TalosThoren/MM-control-2.0/rev.03/MM-control.sch

## KiCad design rev.03/MM-control.sch (2020-08-01)

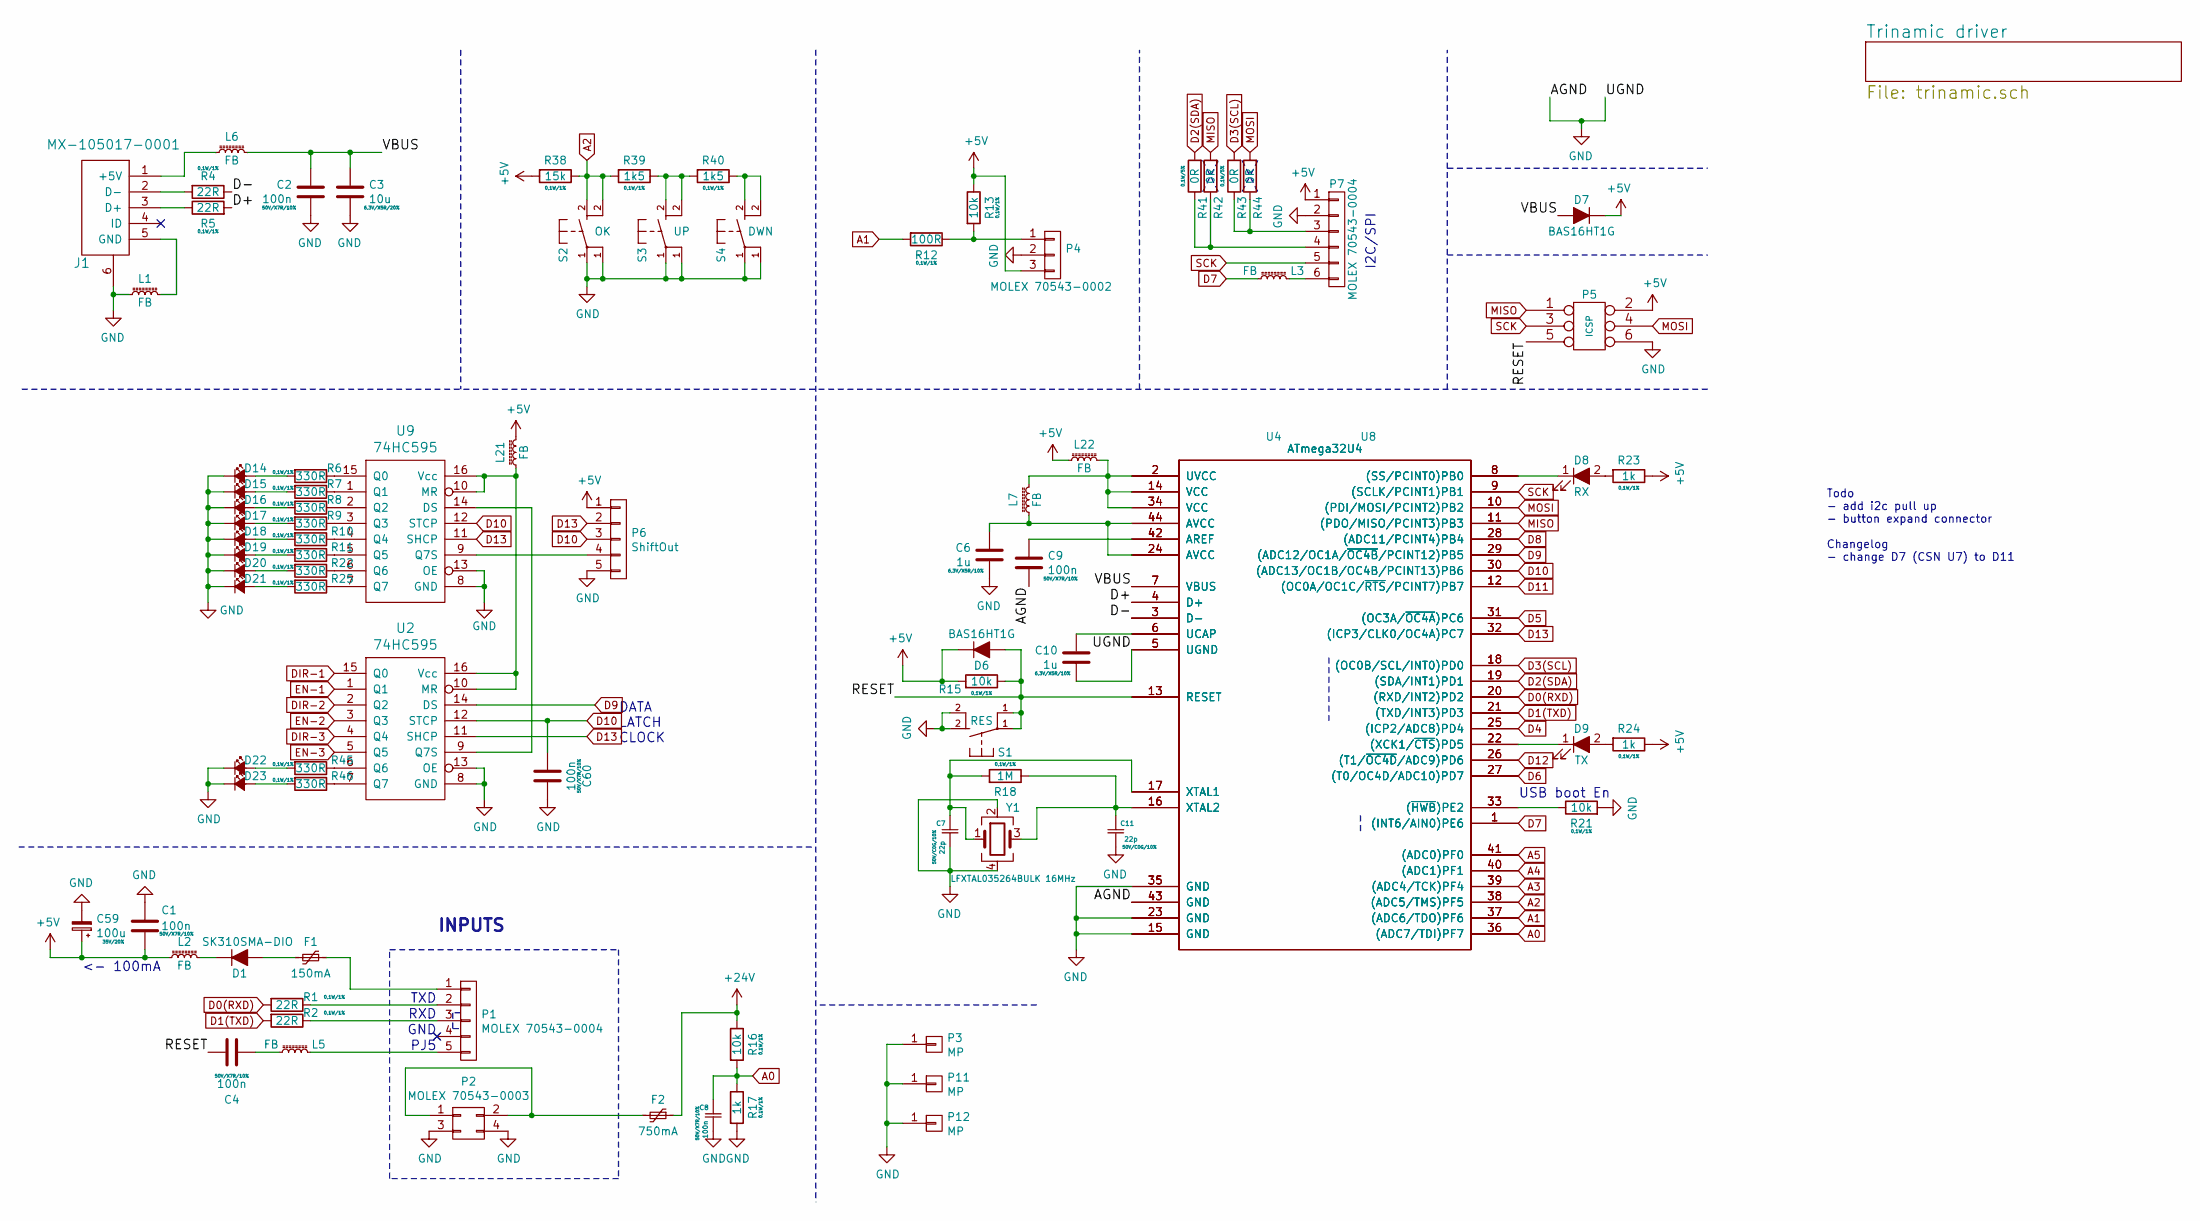
[picture p1: schematic MM-control.sch]

Parts:
C1, C2, C4, C8, C9, C60: 100n; C_0603
C3: 10u; C_0603
C6, C10: 1u; C_0603
C7, C11: 22p; C_0603
C59: 100u; c_elec_6.3x7.7
D1: SK310SMA-DIO; SMA_Standard
D6, D7: BAS16HT1G; SOD-323
D8: RX; LED_0805
D9: TX; LED_0805
D14, D16, D18, D20, D22: KPA-3010MGC; LED-1104
D15, D17, D19, D21, D23: KPA-3010SECK; LED-1104
F1: 150mA; R_1812
F2: 750mA; R_1812
J1: MX-105017-0001; USB-micro
L1, L2, L3, L5, L6, L7, L21, L22: FB; R_0603
P1: MOLEX 70543-0004; Pin_1x05-XL
P2: MOLEX 70543-0003; Pin_1x04-XL
P3, P11, P12: MP; MountingHole_3.2mm_M3_ISO14580_Pad
P4: MOLEX 70543-0002; Pin_1x03-XL
P5: ICSP; Pin_Header_Straight_2x03
P6: ShiftOut; Pin_1x05-XL
P7: MOLEX 70543-0004; Pin_1x06-XL
R1, R2, R4, R5: 22R; R_0603
R6, R7, R8, R9, R10, R11, R22, R25, R45, R46: 330R; R_0603
R12: 100R; R_0603
R13, R15, R16, R21: 10k; R_0603
R17, R23, R24: 1k; R_0603
R18: 1M; R_0603
R38: 15k; R_0603
R39, R40: 1k5; R_0603
R41, R42, R43, R44: 0R; R_0603
S1: RES; TACT-90
S2: OK; TACT-90
S3: UP; TACT-90
S4: DWN; TACT-90
U2, U9: 74HC595; SOIC-16_3.9x9.9mm_Pitch1.27mm
U4: ATmega32U4; TQFP-44_10x10mm_Pitch0.8mm
U8: ATmega32U4; QFN-44-1EP_7x7mm_Pitch0.5mm
Y1: LFXTAL035264BULK 16MHz; Crystal-3.2x2.5mm

Connections:
+5V: C1.1, C59.1, D6.1 (K), D7.1 (K), L2.1, L21.2, L22.1, P4.3, P5.2, P6.1, P7.1, R13.1, R15.2, R23.1, R24.1, R38.2
+24V: F2.1, R16.1
A0: C8.1, R16.2, R17.1, U4.36 ((ADC7/TDI)PF7), U8.36 ((ADC7/TDI)PF7)
A1: R12.2, U4.37 ((ADC6/TDO)PF6), U8.37 ((ADC6/TDO)PF6)
A2: R38.1, R39.2, S2.2, U4.38 ((ADC5/TMS)PF5), U8.38 ((ADC5/TMS)PF5)
A3: U4.39 ((ADC4/TCK)PF4), U8.39 ((ADC4/TCK)PF4)
A4: U4.40 ((ADC1)PF1), U8.40 ((ADC1)PF1)
A5: U4.41 ((ADC0)PF0), U8.41 ((ADC0)PF0)
D0(RXD): R1.2, U4.20 ((RXD/INT2)PD2), U8.20 ((RXD/INT2)PD2)
D1(TXD): R2.2, U4.21 ((TXD/INT3)PD3), U8.21 ((TXD/INT3)PD3)
D2(SDA): R41.2, U4.19 ((SDA/INT1)PD1), U8.19 ((SDA/INT1)PD1)
D3(SCL): R43.2, U4.18 ((OC0B/SCL/INT0)PD0), U8.18 ((OC0B/SCL/INT0)PD0)
D4: U4.25 ((ICP2/ADC8)PD4), U8.25 ((ICP2/ADC8)PD4)
D5: U4.31 ((OC3A/~OC4A~)PC6), U8.31 ((OC3A/~OC4A~)PC6)
D6: U4.27 ((T0/OC4D/ADC10)PD7), U8.27 ((T0/OC4D/ADC10)PD7)
D7: L3.1, U4.1 ((INT6/AIN0)PE6), U8.1 ((INT6/AIN0)PE6)
D8: U4.28 ((ADC11/PCINT4)PB4), U8.28 ((ADC11/PCINT4)PB4)
D9: U2.14 (DS), U4.29 ((ADC12/OC1A/~OC4B~/PCINT12)PB5), U8.29 ((ADC12/OC1A/~OC4B~/PCINT12)PB5)
D10: C60.2, P6.3, U2.12 (STCP), U4.30 ((ADC13/OC1B/OC4B/PCINT13)PB6), U8.30 ((ADC13/OC1B/OC4B/PCINT13)PB6), U9.12 (STCP)
D11: U4.12 ((OC0A/OC1C/~RTS~/PCINT7)PB7), U8.12 ((OC0A/OC1C/~RTS~/PCINT7)PB7)
D12: U4.26 ((T1/~OC4D~/ADC9)PD6), U8.26 ((T1/~OC4D~/ADC9)PD6)
D13: P6.2, U2.11 (SHCP), U4.32 ((ICP3/CLK0/OC4A)PC7), U8.32 ((ICP3/CLK0/OC4A)PC7), U9.11 (SHCP)
D+: R5.2, U4.4 (D+), U8.4 (D+)
D-: R4.1, U4.3 (D-), U8.3 (D-)
DIR-1: U2.15 (Q0)
DIR-2: U2.2 (Q2)
DIR-3: U2.4 (Q4)
EN-1: U2.1 (Q1)
EN-2: U2.3 (Q3)
EN-3: U2.5 (Q5)
GND: C1.2, C2.1, C3.1, C6.1, C7.2, C8.2, C9.1, C10.1, C11.2, C59.2, C60.1, D14.1 (K), D15.1 (K), D16.1 (K), D17.1 (K), D18.1 (K), D19.1 (K), D20.1 (K), D21.1 (K), D22.1 (K), D23.1 (K), J1.6, L1.1, P2.3, P2.4, P3.1, P4.2, P5.6, P6.5, P7.2, P11.1, P12.1, R17.2, R21.2, S1.2, S2.1, S3.1, S4.1, U2.8 (GND), U2.13 (OE), U4.5 (UGND), U4.15 (GND), U4.23 (GND), U4.35 (GND), U4.43 (GND), U8.5 (UGND), U8.15 (GND), U8.23 (GND), U8.35 (GND), U8.43 (GND), U9.8 (GND), U9.13 (OE), Y1.2, Y1.4
MISO: P5.1, R42.2, U4.11 ((PDO/MISO/PCINT3)PB3), U8.11 ((PDO/MISO/PCINT3)PB3)
MOSI: P5.4, R44.2, U4.10 ((PDI/MOSI/PCINT2)PB2), U8.10 ((PDI/MOSI/PCINT2)PB2)
unnamed: C4.1, L5.1
unnamed: C6.2, L7.1, U4.24 (AVCC), U4.44 (AVCC), U8.24 (AVCC), U8.44 (AVCC)
unnamed: C7.1, R18.2, U4.17 (XTAL1), U8.17 (XTAL1), Y1.1
unnamed: C9.2, U4.42 (AREF), U8.42 (AREF)
unnamed: C10.2, U4.6 (UCAP), U8.6 (UCAP)
unnamed: C11.1, R18.1, U4.16 (XTAL2), U8.16 (XTAL2), Y1.3
unnamed: D1.1 (K), L2.2
unnamed: D1.2 (A), F1.2
unnamed: D8.1 (K), U4.8 ((SS/PCINT0)PB0), U8.8 ((SS/PCINT0)PB0)
unnamed: D8.2 (A), R23.2
unnamed: D9.1 (K), U4.22 ((XCK1/~CTS~)PD5), U8.22 ((XCK1/~CTS~)PD5)
unnamed: D9.2 (A), R24.2
unnamed: D14.2 (A), R6.2
unnamed: D15.2 (A), R7.2
unnamed: D16.2 (A), R8.2
unnamed: D17.2 (A), R9.2
unnamed: D18.2 (A), R10.2
unnamed: D19.2 (A), R11.2
unnamed: D20.2 (A), R22.2
unnamed: D21.2 (A), R25.2
unnamed: D22.2 (A), R45.2
unnamed: D23.2 (A), R46.2
unnamed: F1.1, P1.1
unnamed: F2.2, P2.1, P2.2
unnamed: J1.1 (+5V), L6.1
unnamed: J1.2 (D-), R4.2
unnamed: J1.3 (D+), R5.1
unnamed: J1.5 (GND), L1.2
unnamed: L3.2, P7.6
unnamed: L5.2, P1.5
unnamed: L21.1, U2.10 (MR), U2.16 (Vcc), U9.10 (MR), U9.16 (Vcc)
unnamed: L7.2, L22.2, U4.2 (UVCC), U4.14 (VCC), U4.34 (VCC), U8.2 (UVCC), U8.14 (VCC), U8.34 (VCC)
unnamed: P1.2, R1.1
unnamed: P1.3, R2.1
unnamed: P4.1, R12.1, R13.2
unnamed: P6.4, U9.9 (Q7S)
unnamed: P7.3, R43.1, R44.1
unnamed: P7.4, R41.1, R42.1
unnamed: R6.1, U9.15 (Q0)
unnamed: R7.1, U9.1 (Q1)
unnamed: R8.1, U9.2 (Q2)
unnamed: R9.1, U9.3 (Q3)
unnamed: R10.1, U9.4 (Q4)
unnamed: R11.1, U9.5 (Q5)
unnamed: R21.1, U4.33 ((~HWB~)PE2), U8.33 ((~HWB~)PE2)
unnamed: R22.1, U9.6 (Q6)
unnamed: R25.1, U9.7 (Q7)
unnamed: R39.1, R40.2, S3.2
unnamed: R40.1, S4.2
unnamed: R45.1, U2.6 (Q6)
unnamed: R46.1, U2.7 (Q7)
unnamed: U2.9 (Q7S), U9.14 (DS)
RESET: C4.2, D6.2 (A), P5.5, R15.1, S1.1, U4.13 (RESET), U8.13 (RESET)
SCK: P5.3, P7.5, U4.9 ((SCLK/PCINT1)PB1), U8.9 ((SCLK/PCINT1)PB1)
VBUS: C2.2, C3.2, D7.2 (A), L6.2, U4.7 (VBUS), U8.7 (VBUS)

Notes on the sheet:
TXD
RXD
PJ5
USB boot En
INPUTS
DATA LATCH CLOCK
GND
I2C/SPI
<- 100mA
Todo - add i2c pull up - button expand connector Changelog - change D7 (CSN U7) to D11
