TalosThoren/MM-control-2.0/rev.03/trinamic.sch

## KiCad design rev.03/trinamic.sch (2020-08-01)

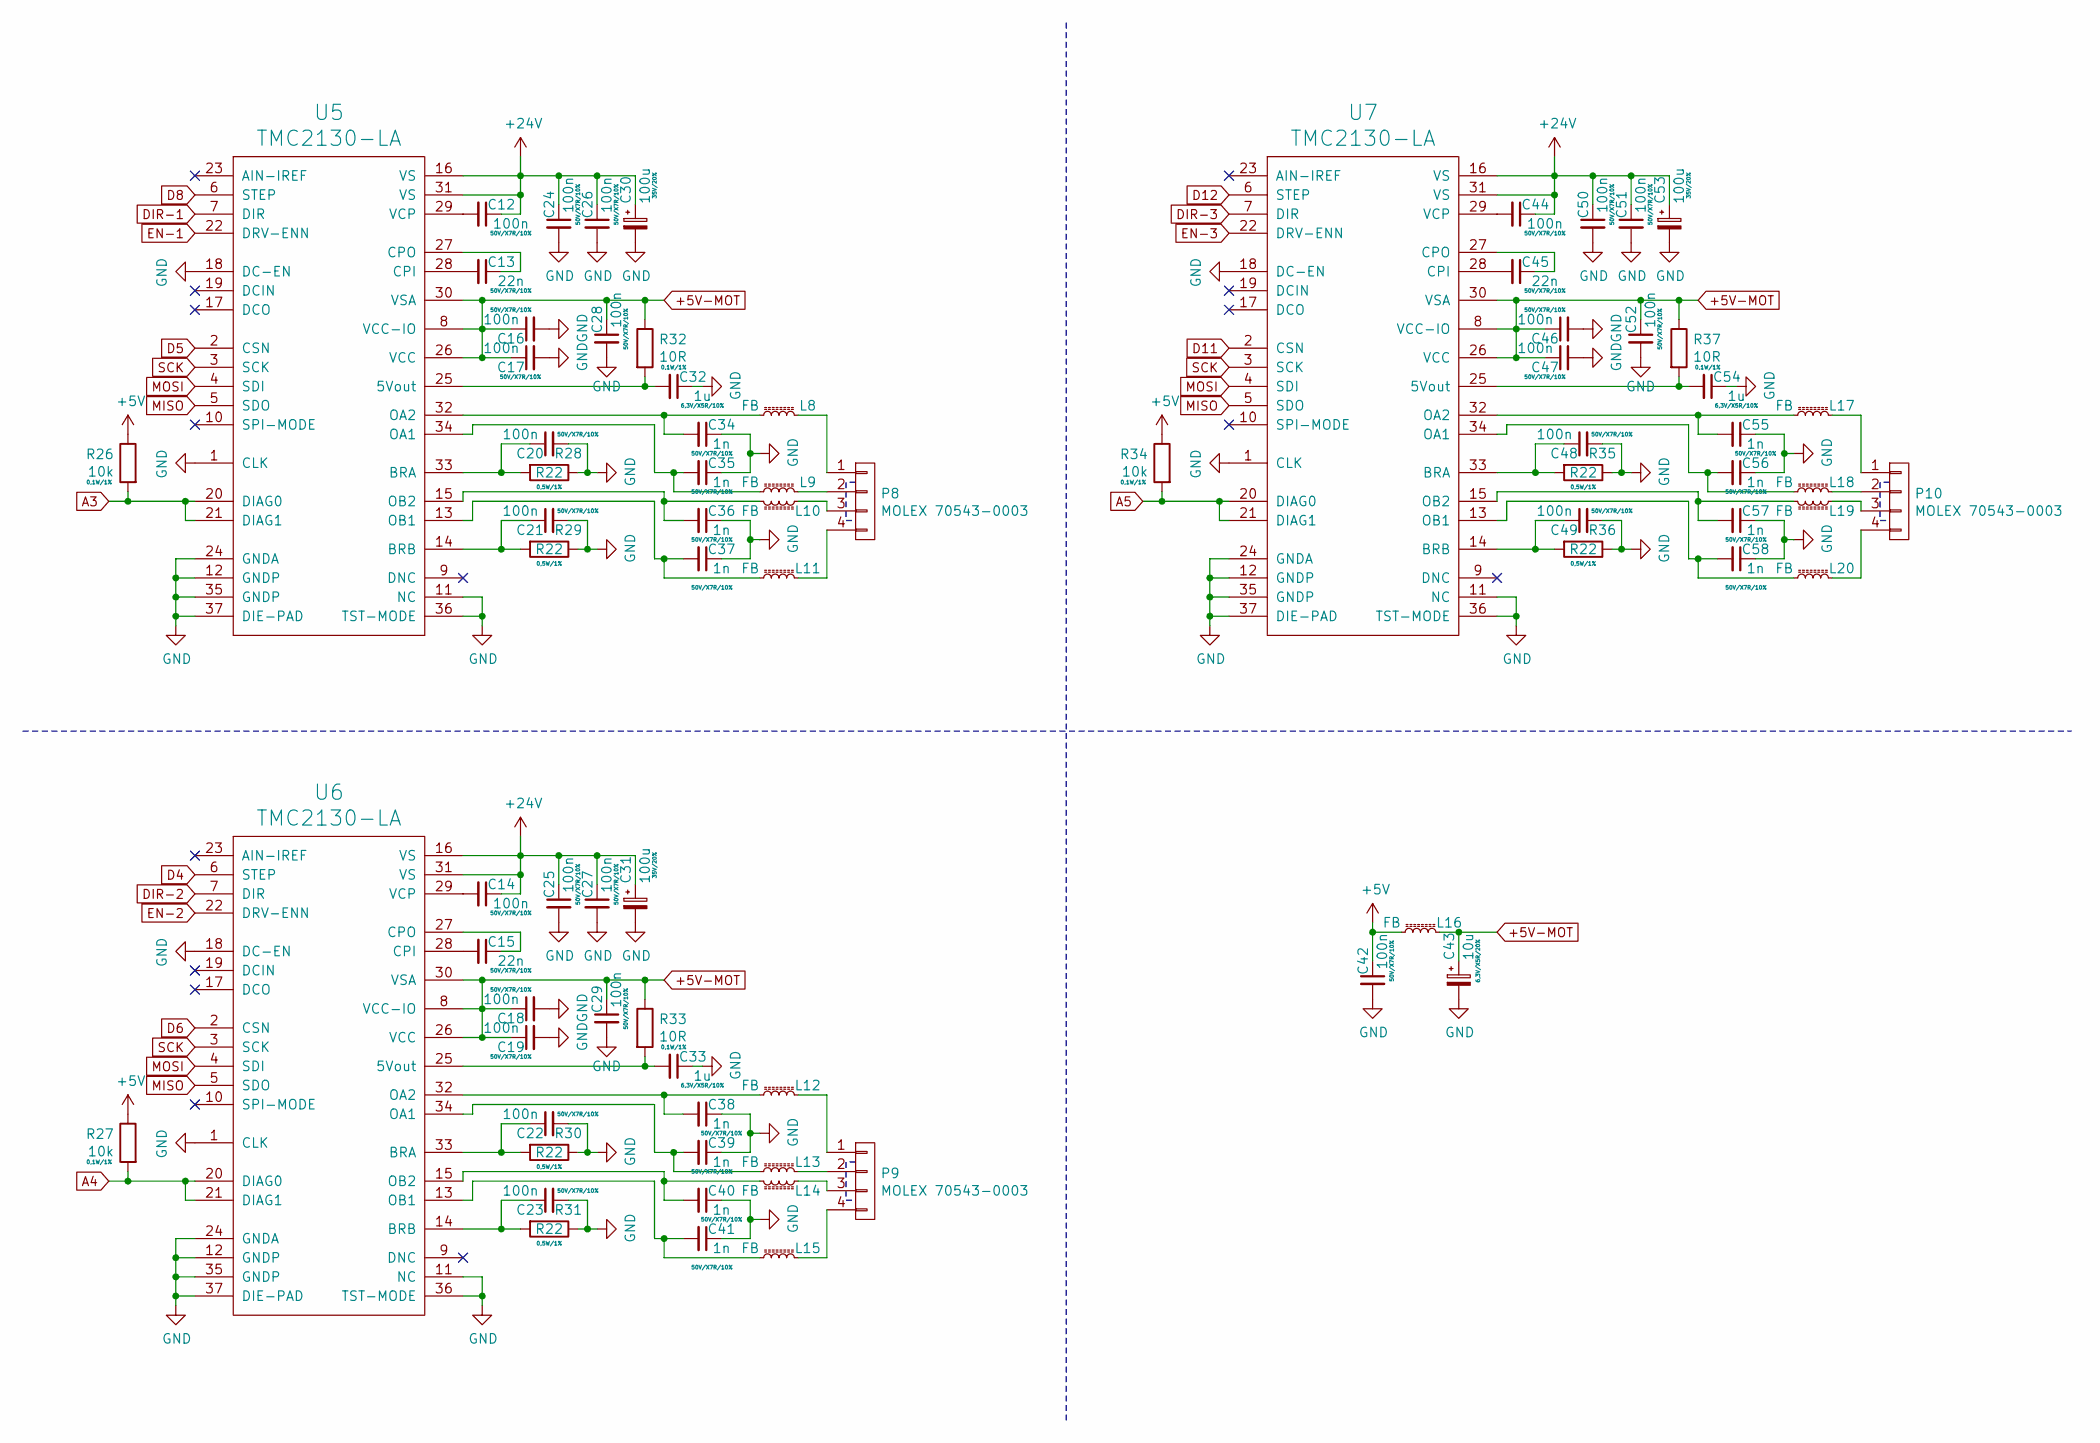
[picture p2: schematic trinamic.sch]

Parts:
C12, C14, C16, C17, C18, C19, C20, C21, C22, C23, C24, C25, C26, C27, C28, C29, C42, C44, C46, C47, C48, C49, C50, C51, C52: 100n; C_0603
C13, C15, C45: 22n; C_0603
C30, C31, C53: 100u; c_elec_6.3x7.7
C32, C33, C54: 1u; C_0603
C34, C35, C36, C37, C38, C39, C40, C41, C55, C56, C57, C58: 1n; C_0603
C43: 10u; C_0603
L8, L9, L10, L11, L12, L13, L14, L15, L16, L17, L18, L19, L20: FB; R_0603
P8, P9, P10: MOLEX 70543-0003; Pin_1x04-XL
R26, R27, R34: 10k; R_0603
R28, R29, R30, R31, R35, R36: R22; R_1206
R32, R33, R37: 10R; R_0603
U5, U6, U7: TMC2130-LA; QFN-36-1EP_5x6mm_Pitch0.5mm-GNDpad-0.3mm

Connections:
+5V: C42.1, L16.1, R26.1, R27.1, R34.1
+5V-MOT: C16.1, C17.1, C18.1, C19.1, C28.1, C29.1, C43.1, C46.1, C47.1, C52.1, L16.2, R32.1, R33.1, R37.1, U5.8 (VCC-IO), U5.26 (VCC), U5.30 (VSA), U6.8 (VCC-IO), U6.26 (VCC), U6.30 (VSA), U7.8 (VCC-IO), U7.26 (VCC), U7.30 (VSA)
+24V: C12.1, C14.1, C24.1, C25.1, C26.1, C27.1, C30.1, C31.1, C44.1, C50.1, C51.1, C53.1, U5.16 (VS), U5.31 (VS), U6.16 (VS), U6.31 (VS), U7.16 (VS), U7.31 (VS)
A3: R26.2, U5.20 (DIAG0), U5.21 (DIAG1)
A4: R27.2, U6.20 (DIAG0), U6.21 (DIAG1)
A5: R34.2, U7.20 (DIAG0), U7.21 (DIAG1)
D4: U6.6 (STEP)
D5: U5.2 (CSN)
D6: U6.2 (CSN)
D8: U5.6 (STEP)
D11: U7.2 (CSN)
D12: U7.6 (STEP)
DIR-1: U5.7 (DIR)
DIR-2: U6.7 (DIR)
DIR-3: U7.7 (DIR)
EN-1: U5.22 (DRV-ENN)
EN-2: U6.22 (DRV-ENN)
EN-3: U7.22 (DRV-ENN)
GND: C16.2, C17.2, C18.2, C19.2, C20.2, C21.2, C22.2, C23.2, C24.2, C25.2, C26.2, C27.2, C28.2, C29.2, C30.2, C31.2, C32.1, C33.1, C34.1, C35.1, C36.1, C37.1, C38.1, C39.1, C40.1, C41.1, C42.2, C43.2, C46.2, C47.2, C48.2, C49.2, C50.2, C51.2, C52.2, C53.2, C54.1, C55.1, C56.1, C57.1, C58.1, R28.1, R29.1, R30.1, R31.1, R35.1, R36.1, U5.1 (CLK), U5.11 (NC), U5.12 (GNDP), U5.18 (DC-EN), U5.24 (GNDA), U5.35 (GNDP), U5.36 (TST-MODE), U5.37 (DIE-PAD), U6.1 (CLK), U6.11 (NC), U6.12 (GNDP), U6.18 (DC-EN), U6.24 (GNDA), U6.35 (GNDP), U6.36 (TST-MODE), U6.37 (DIE-PAD), U7.1 (CLK), U7.11 (NC), U7.12 (GNDP), U7.18 (DC-EN), U7.24 (GNDA), U7.35 (GNDP), U7.36 (TST-MODE), U7.37 (DIE-PAD)
MISO: U5.5 (SDO), U6.5 (SDO), U7.5 (SDO)
MOSI: U5.4 (SDI), U6.4 (SDI), U7.4 (SDI)
unnamed: C12.2, U5.29 (VCP)
unnamed: C13.1, U5.27 (CPO)
unnamed: C13.2, U5.28 (CPI)
unnamed: C14.2, U6.29 (VCP)
unnamed: C15.1, U6.27 (CPO)
unnamed: C15.2, U6.28 (CPI)
unnamed: C20.1, R28.2, U5.33 (BRA)
unnamed: C21.1, R29.2, U5.14 (BRB)
unnamed: C22.1, R30.2, U6.33 (BRA)
unnamed: C23.1, R31.2, U6.14 (BRB)
unnamed: C32.2, R32.2, U5.25 (5Vout)
unnamed: C33.2, R33.2, U6.25 (5Vout)
unnamed: C34.2, L8.1, U5.32 (OA2)
unnamed: C35.2, L9.1, U5.34 (OA1)
unnamed: C36.2, L10.1, U5.15 (OB2)
unnamed: C37.2, L11.1, U5.13 (OB1)
unnamed: C38.2, L12.1, U6.32 (OA2)
unnamed: C39.2, L13.1, U6.34 (OA1)
unnamed: C40.2, L14.1, U6.15 (OB2)
unnamed: C41.2, L15.1, U6.13 (OB1)
unnamed: C44.2, U7.29 (VCP)
unnamed: C45.1, U7.27 (CPO)
unnamed: C45.2, U7.28 (CPI)
unnamed: C48.1, R35.2, U7.33 (BRA)
unnamed: C49.1, R36.2, U7.14 (BRB)
unnamed: C54.2, R37.2, U7.25 (5Vout)
unnamed: C55.2, L17.1, U7.32 (OA2)
unnamed: C56.2, L18.1, U7.34 (OA1)
unnamed: C57.2, L19.1, U7.15 (OB2)
unnamed: C58.2, L20.1, U7.13 (OB1)
unnamed: L8.2, P8.1
unnamed: L9.2, P8.2
unnamed: L10.2, P8.3
unnamed: L11.2, P8.4
unnamed: L12.2, P9.1
unnamed: L13.2, P9.2
unnamed: L14.2, P9.3
unnamed: L15.2, P9.4
unnamed: L17.2, P10.1
unnamed: L18.2, P10.2
unnamed: L19.2, P10.3
unnamed: L20.2, P10.4
SCK: U5.3 (SCK), U6.3 (SCK), U7.3 (SCK)
