TalosThoren/MM-control-2.0/(notices)

Notices in the files:
rev.03/trinamic.sch:
http://creativecommons.org/licenses/by-sa/4.0
Licensed under the Attribution-ShareAlike 4.0 International (CC BY-SA 4.0)
